LieBtrau/daddyslight/wiki/RequirementsSpecification.wiki

#summary Specifications

= Requirements specification =
 * back light 
 * red
 * easily mounted on the back of my daddy's bike
 * mounting should be fix, so that the light can't be stolen
 * preferably wide opening angle of the light, so that it can be seen from different angles
 * should be as bright as possible
 * must be powered by the bike dynamo.
 * shouldn't cost more than about €10.

Extra requirement:
 * LED must remain on for 1 minute after cycling (e.g. when waiting for traffic lights).
