LieBtrau/daddyslight/LTSpice/ChargePump_LongOFF.asc

C1: cap; 220µ
D1: LED; QTLP690C
D2: diode
D3: diode
D4: LED; QTLP690C
M1: pmos; BSS84
R1: res; 220
R2: res; 220
R3: res; 10K
R4: res; 0.01
U1: 2N7002
V1: signal; PULSE(0 5 0.0001 0.0001 0.0001 0.075 0.1)
V2: voltage; 5; Rser=33
V3: voltage; 0
Named nets: 0
.tran 1S
