LieBtrau/daddyslight/LTSpice/ChargePump_LongON.asc

C1: cap; 470µ
D1: LED; QTLP690C
M1: pmos; BSS84
R1: res; 470
R2: res; 220
U1: 2N7002
V1: signal; PULSE(0 3 0.0001 0.0001 0.0001 0.075 0.1)
V2: voltage; 5V
Named nets: 0
.tran 1S
