LieBtrau/daddyslight/LTSpice/LEDdriver.asc

D1: LED; QTLP690C
Q1: npn2; BC847A
Q2: npn2; BC847A
R1: res; 39E
R2: res; 1K
V1: voltage; 5; Rser=50
Named nets: 0
;op
.dc V1 0V 10V 0.1V
