LieBtrau/daddyslight/(list of files, drawings)

Other design files:
DesignSpark/DaddyBacklight.pcb
