LieBtrau/daddyslight/(commit log)

2010-10-11 R000A: schematic finished
    [DaddyBacklight.pcb, DaddyBacklight.sch]
2010-10-23 Routing finished
    [DaddyBacklight.pcb, DaddyBacklight.sch]
2010-10-27 Security copy
    [DaddyBacklight.pcb, DaddyBacklight.sch]
2010-10-30 R000 of the design
    [DaddyBacklight.pcb, DaddyBacklight.sch]
2010-11-02 Updating BOM
    [DaddyBacklight.sch]
2010-12-13 R100 of the design.
    [DaddyBacklight.pcb, DaddyBacklight.sch]
2011-02-01 Version 2.00 of Daddy's backlight
    [DaddyBacklight.pcb, DaddyBacklight.sch]
2011-02-03 Version 3.00 of Daddy's backlight
    [DaddyBacklight.pcb, DaddyBacklight.sch]
